LennartKlaver/SDVN1/Documentation/Shine1Hardware.jpg

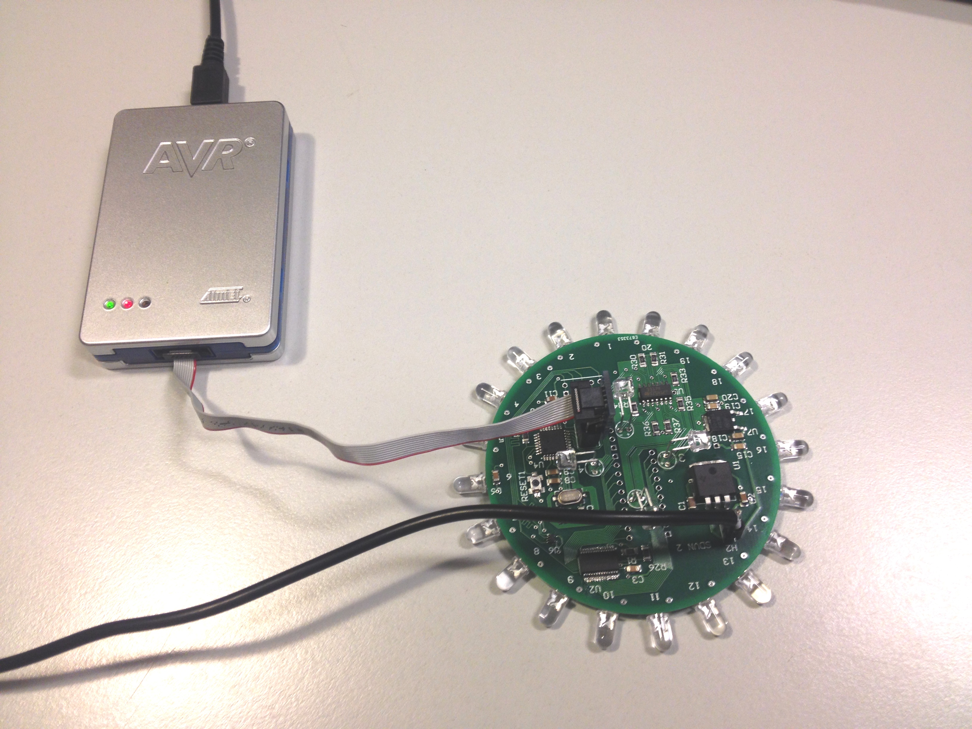
Documentation/Shine1Hardware.jpg
