LennartKlaver/SDVN1/Documentation/Shine1PDmount.jpg

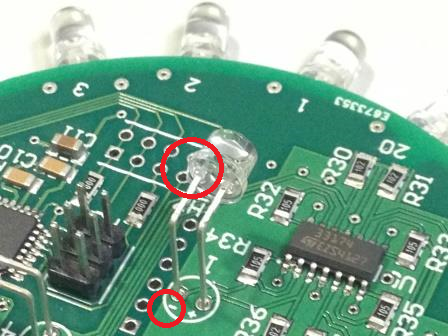
Documentation/Shine1PDmount.jpg
