LennartKlaver/SDVN1/README.md

# SDVN2
Shine: Developing Visual Networking

This repo contains the software and hardware for the Shine project in the Embedded Software group of the faculty EEMCS at Delft University of Technology.

The source files are part of [this paper](http://citeseerx.ist.psu.edu/viewdoc/download?doi=10.1.1.728.4979&rep=rep1&type=pdf) and [this Master thesis](http://resolver.tudelft.nl/uuid:439b72d1-0a8b-4132-8370-b539c8a13574)

[Embedded Software group website](http://www.es.ewi.tudelft.nl/)  

For questions please contact Lennart Klaver or Marco Zuniga.
