LennartKlaver/SDVN1/Documentation/PulsePositionModulation.png

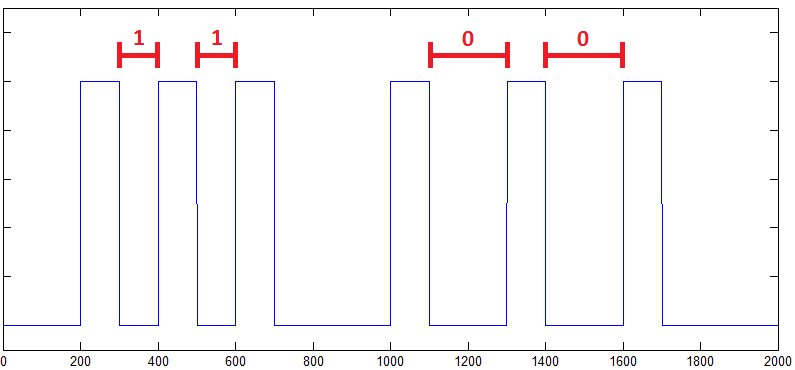
Documentation/PulsePositionModulation.png
