LennartKlaver/SDVN1/Documentation/sampling.png

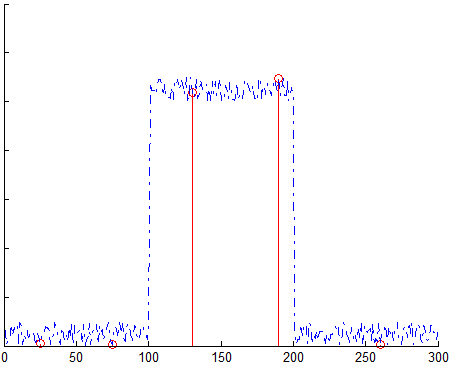
Documentation/sampling.png
