LennartKlaver/SDVN1/Documentation/signal.png

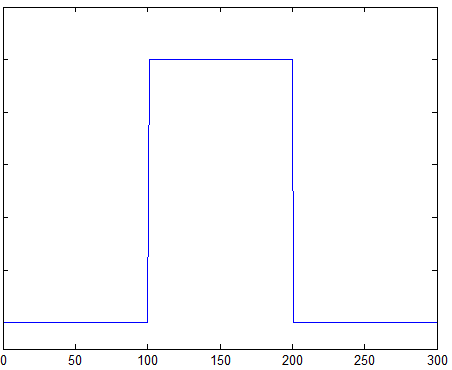
Documentation/signal.png
