LennartKlaver/SDVN1/Documentation/signalnoise.png

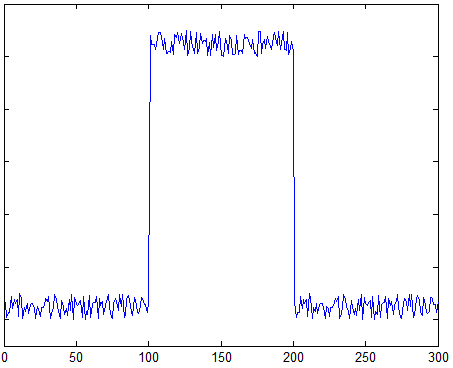
Documentation/signalnoise.png
