LennartKlaver/SDVN1/Hardware/SDVN2 schematic.pdf

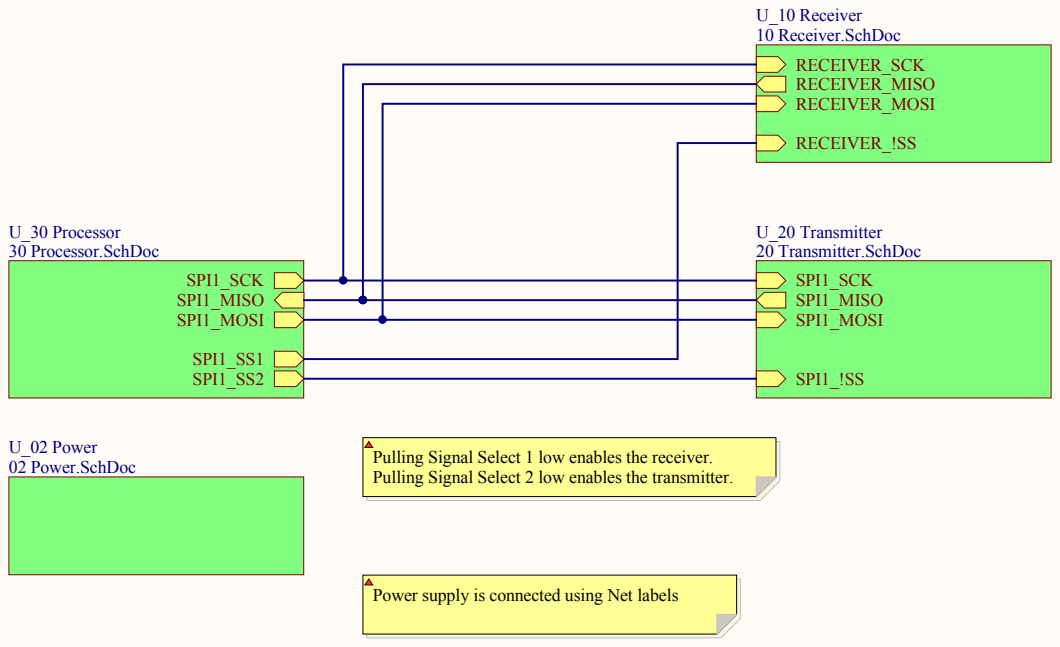
[picture p7: page 1]

Pulling Signal Select 1 low enables the receiver.
Pulling Signal Select 2 low enables the transmitter.

Power supply is connected using Net labels

Description: Top level overview

Drawn by: L.P. Klaver | Project: SDVN test1

Delft University of Technology | Sheet 1 of 12 | Rev.:14-3-2014

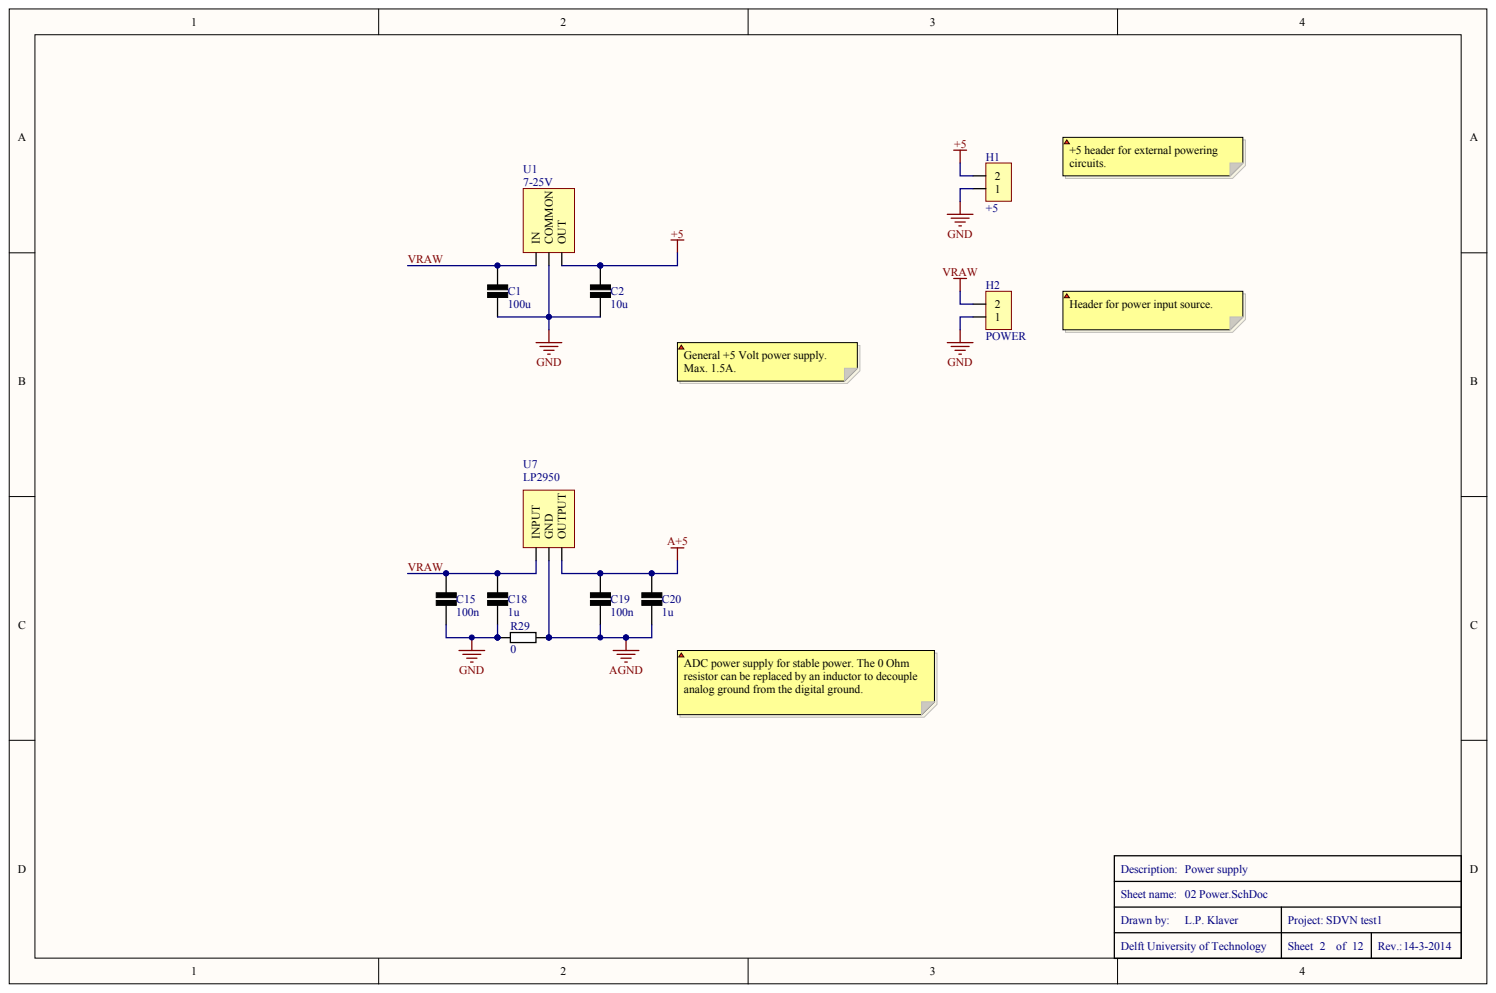
[picture p8: page 2]

ader for external powering

ader for power input sourc

General +5 Volt power supply.
Max. 1.5A.

ADC power supply for stable power. The 0 Ohm
sistor c
analog ground from the digital ground.

ed by an inductor to de

Drawn by: L.P. Klave r | Proje ct: SDVN te st1

Delft University of Te chnology | She et of 2 12 | Rev.:14-3-2014

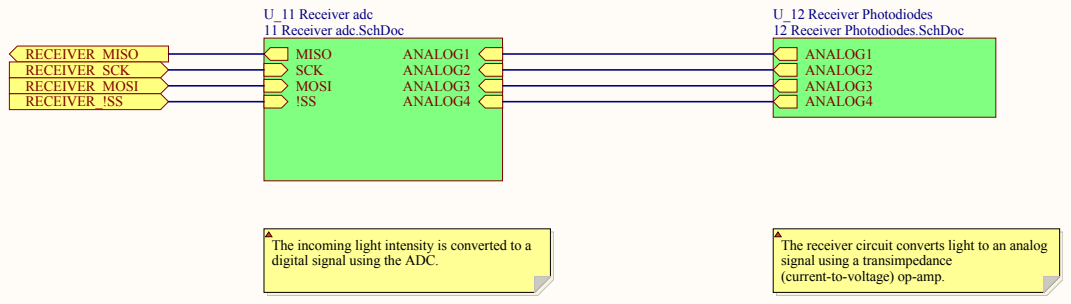
[picture p9: page 3]

The incoming light intensity is converted to a
digital signal using the ADC.

The receiver circuit converts light to an analog
signal using a transimpedance
(current-to-voltage) op-amp.

Drawn by: L.P. Klaver | Project: SDVN test1

Sheet of 3 12

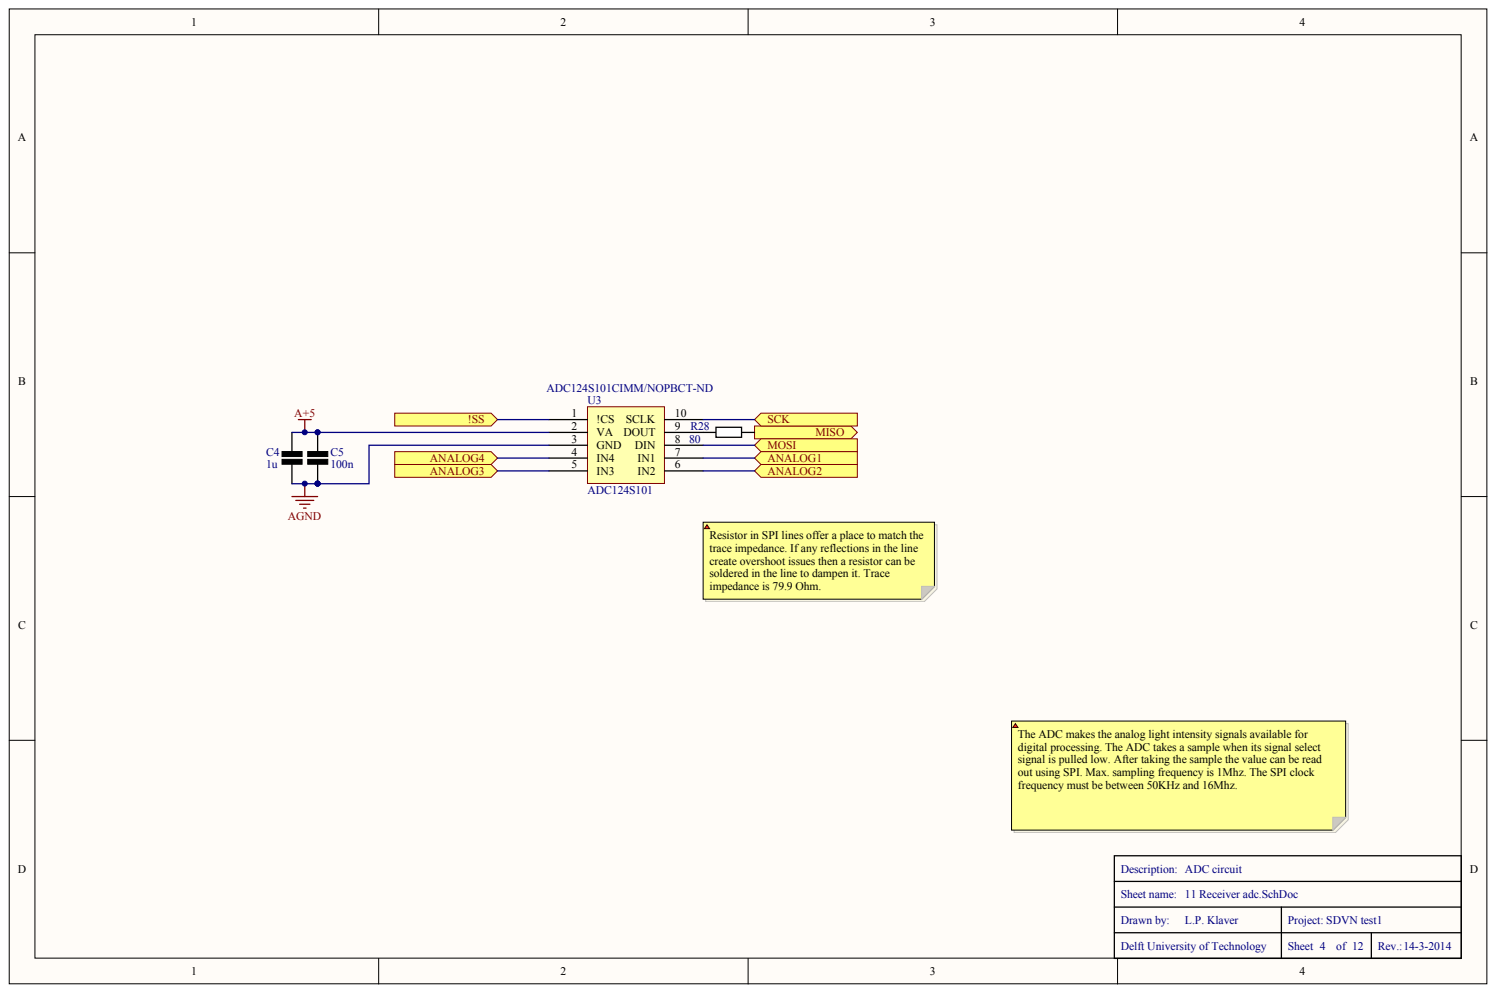
[picture p10: page 4]

C5 ANALOG4 100n

sistor in SPI line
e impedanc
tra
ate overshoot is
cre
soldered in the line to dampen it. Tra
impedanc

The ADC make
digital proc
signal is pulled low. After taking the s
out using SPI. Max. s
frequency must be betwe

s the analog light intensity signals available for
sing. The ADC take

ample when its signal s
ample the value c

ampling frequency is 1Mhz. The SPI clock
en 50KHz and 16Mhz

Drawn by: L.P. Klave r | Proje ct: SDVN te st1

Delft University of Te chnology | She et of 4 12 | Rev.:14-3-2014

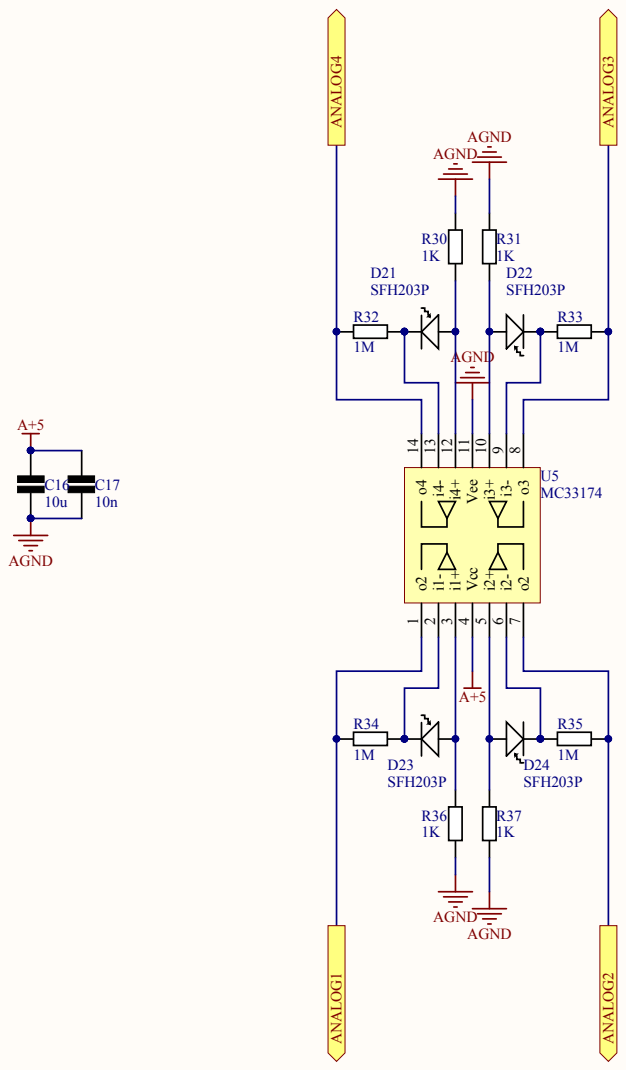
[picture p11: page 5]

Description: Photodiode and op-amp circuit

Drawn by: L.P. Klaver | Project: SDVN test1

Sheet of 5 12

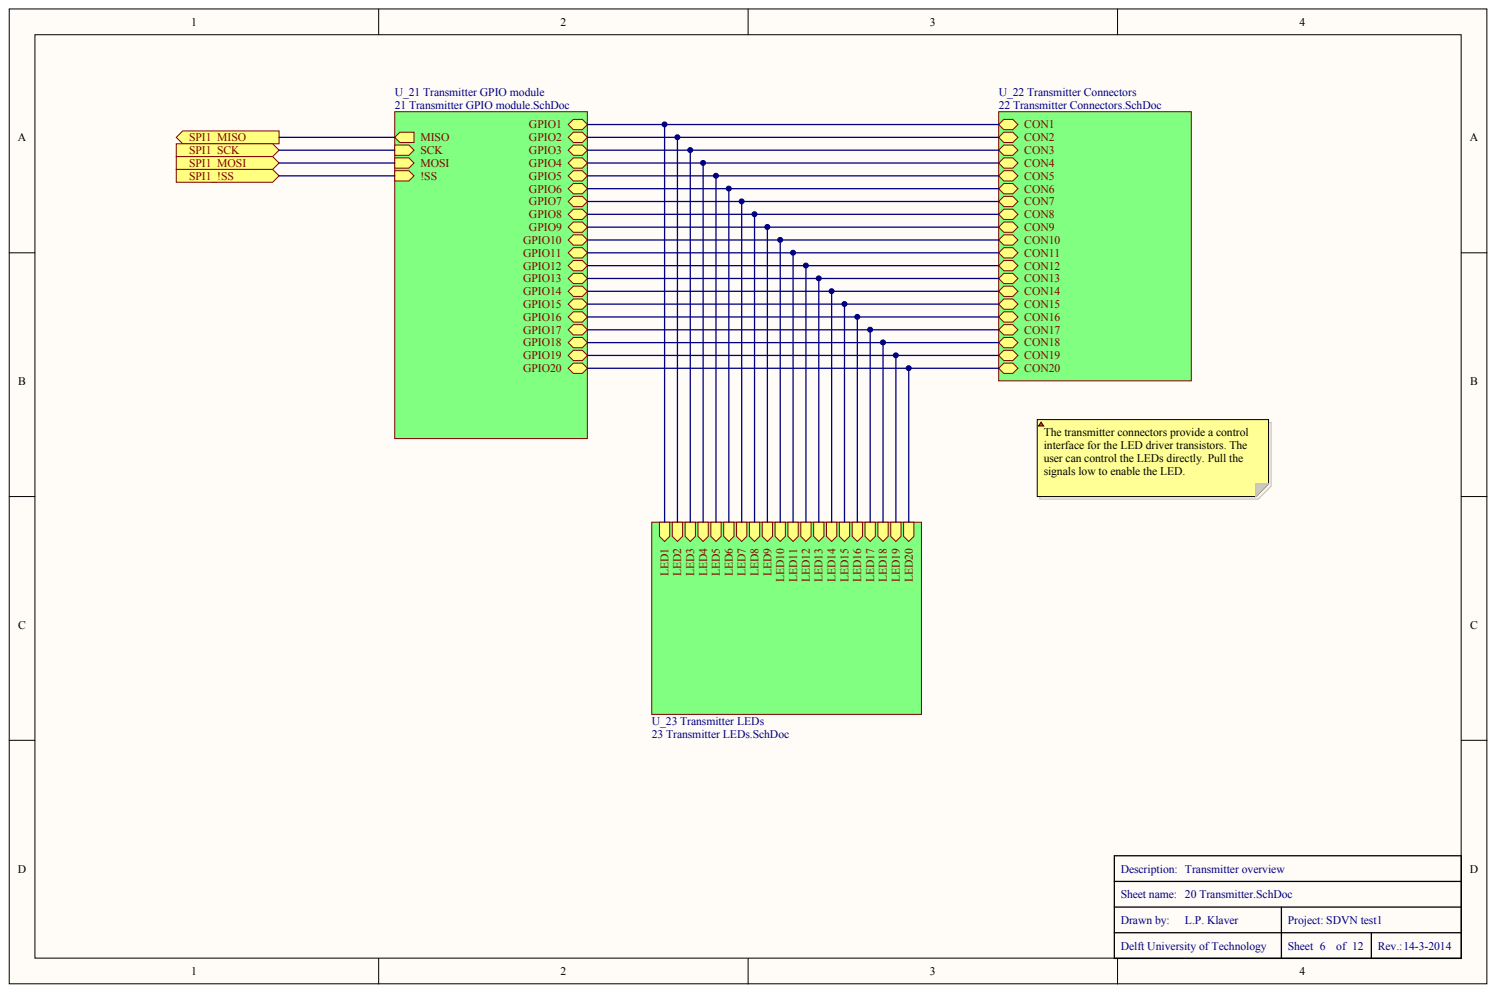
[picture p12: page 6]

U_21 Transmitter GPIO module
21 Transmitter GPIO module.SchDoc

The transmitter connectors provide a control
interface for the LED driver transistors. The
user can control the LEDs directly. Pull the
signals low to enable the LED.

Drawn by: L.P. Klaver | Project: SDVN test1

Sheet of 6 12

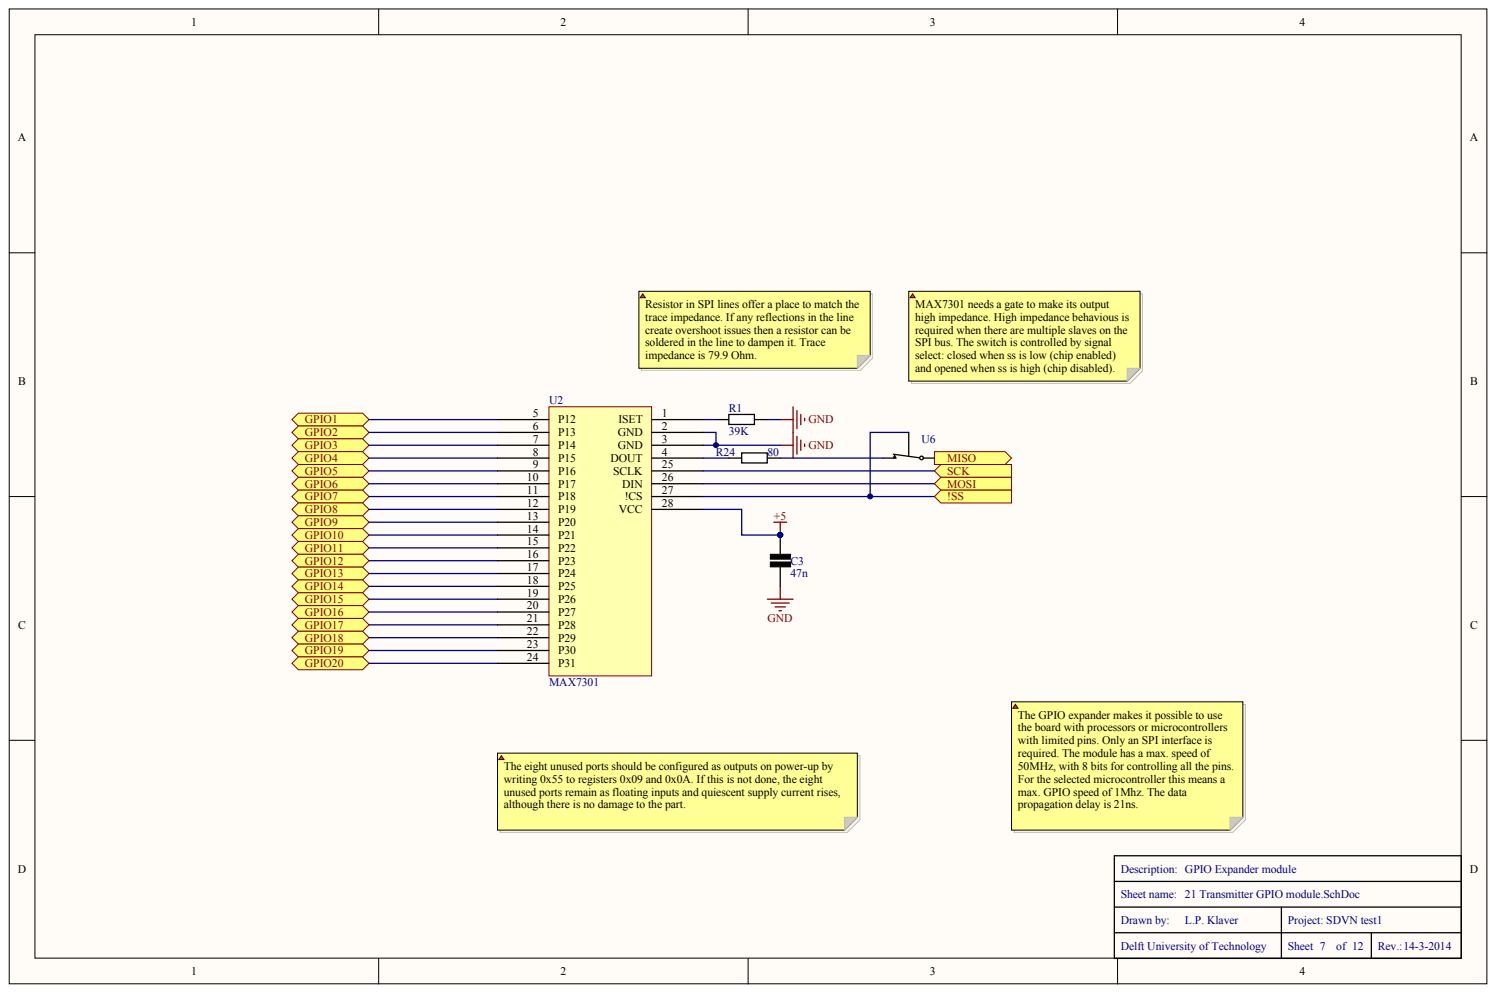
[picture p13: page 7]
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

MAX7301 ne
high impedanc
required when there are multiple slave
SPI bus. The switch is controlled by signal select: closed when ss is low (chip enabled) and opened when ss is high (chip disabled).

eds a gate to make its output
e. High impedanc

The GPIO expander make
the board with proc
with limited pins. Only an SPI interfa
required. The module ha
50MHz, with 8 bits for controlling all the pins
For the s
max. GPIO spe
propagation delay is 21ns

The eight unus
writing 0x55 to registers 0x09 and 0x0A. If this is not done, the eight
ed ports remain a
unus
although there is no damage to the part.

ed ports should be configured a

s outputs on power-up by

ele
ed of 1Mhz. The data

cted microcontroller this me

s floating inputs and quie

ent supply current ris

cription: GPIO Expander module

21 Transmitter GPIO module.SchDoc

Drawn by: L.P. Klave r | Proje ct: SDVN te st1

Delft University of Te chnology | She et of 7 12 | Rev.:14-3-2014

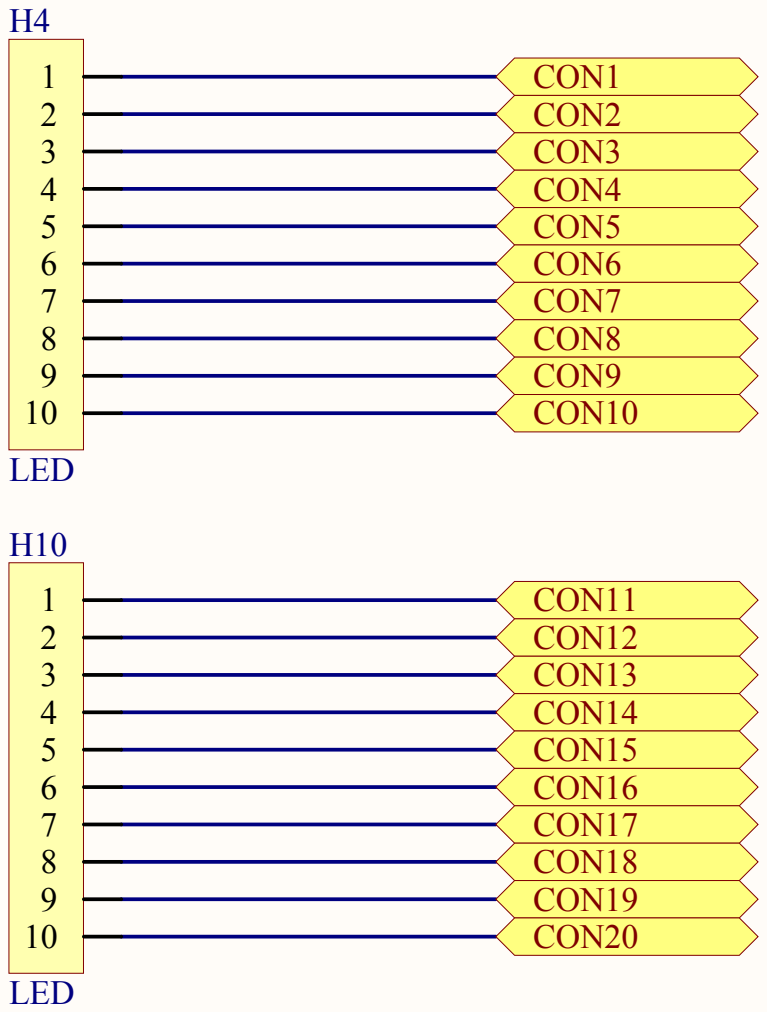
[picture p14: page 8]

Drawn by: L.P. Klave r | Proje ct: SDVN te st1

Delft University of Te chnology | She et of 8 12 | Rev.:14-3-2014

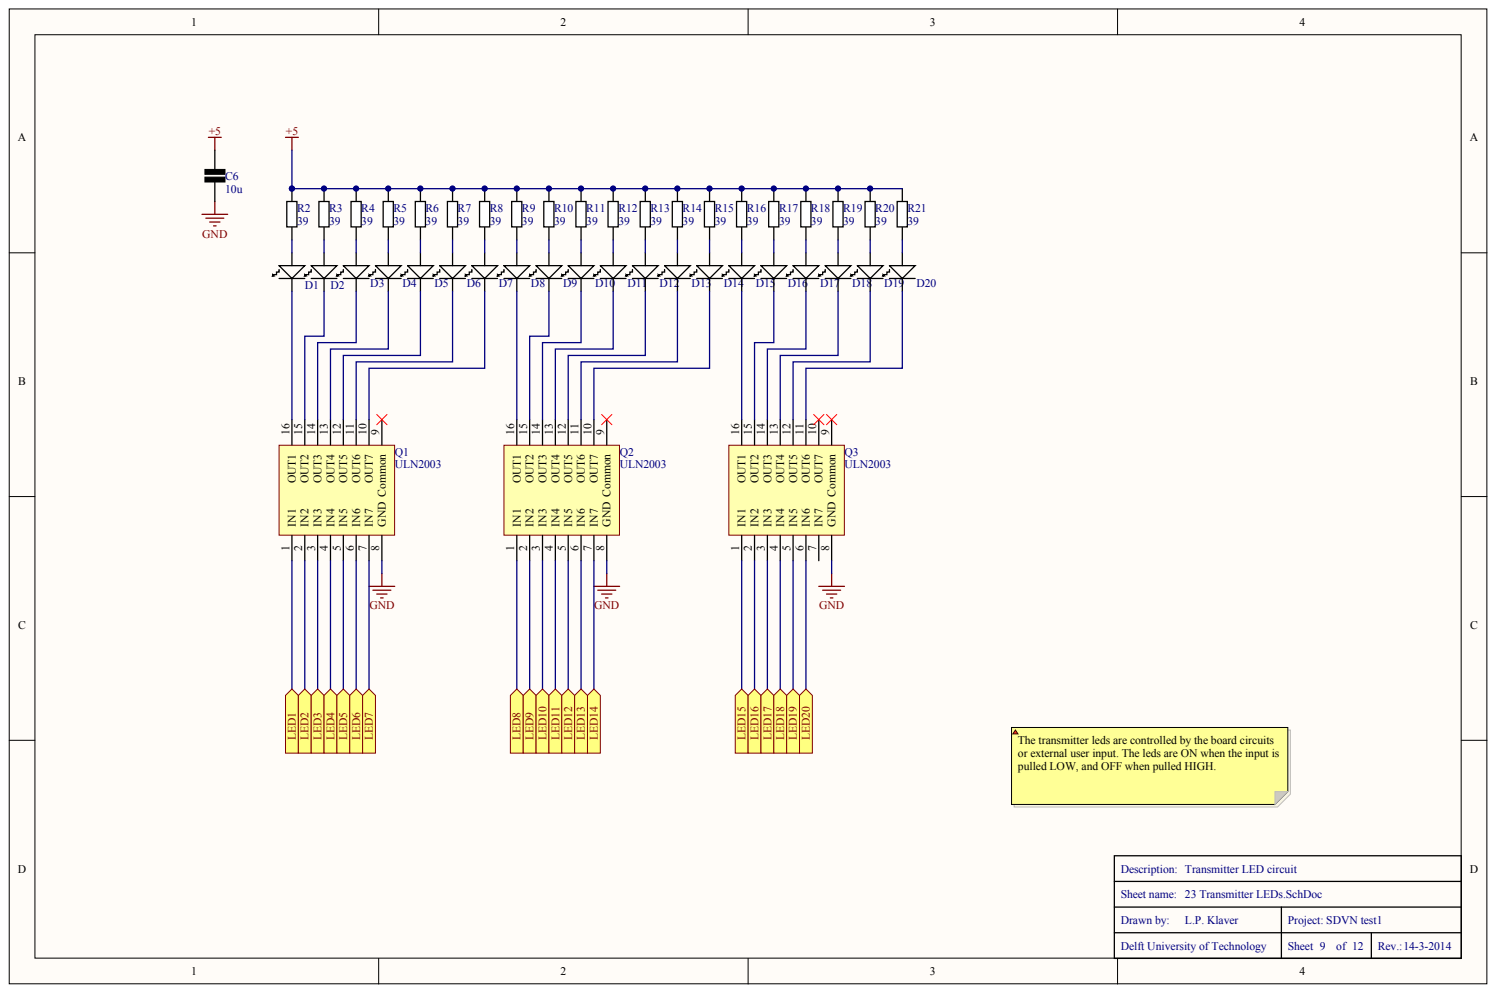
[picture p15: page 9]

The transmitter leds are controlled by the board circuits
or external user input. The leds are ON when the input is
pulled LOW, and OFF when pulled HIGH.

Description: Transmitter LED circuit

Drawn by: L.P. Klaver | Project: SDVN test1

Sheet of 9 12

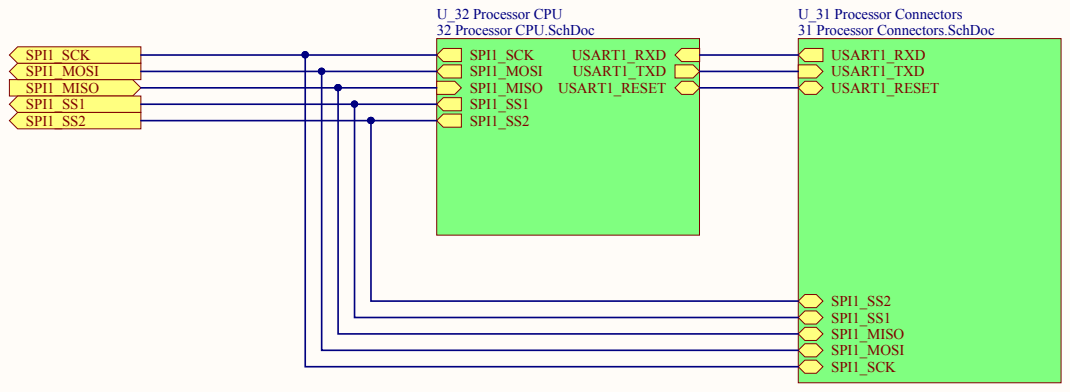
[picture p16: page 10]

Drawn by: L.P. Klaver | Project: SDVN test1

Sheet of 10 12

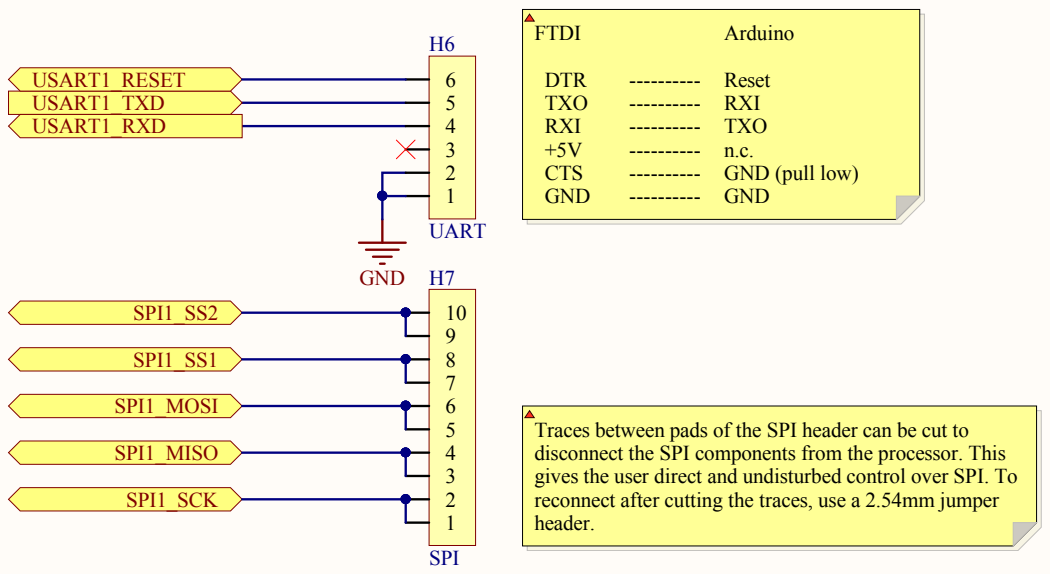
[picture p17: page 11]

Traces between pads of the SPI header can be cut to
disconnect the SPI components from the processor. This
gives the user direct and undisturbed control over SPI. To
reconnect after cutting the traces, use a 2.54mm jumper
header.

Description: Processor interface connectors

Drawn by: L.P. Klaver | Project: SDVN test1

Sheet of 11 12

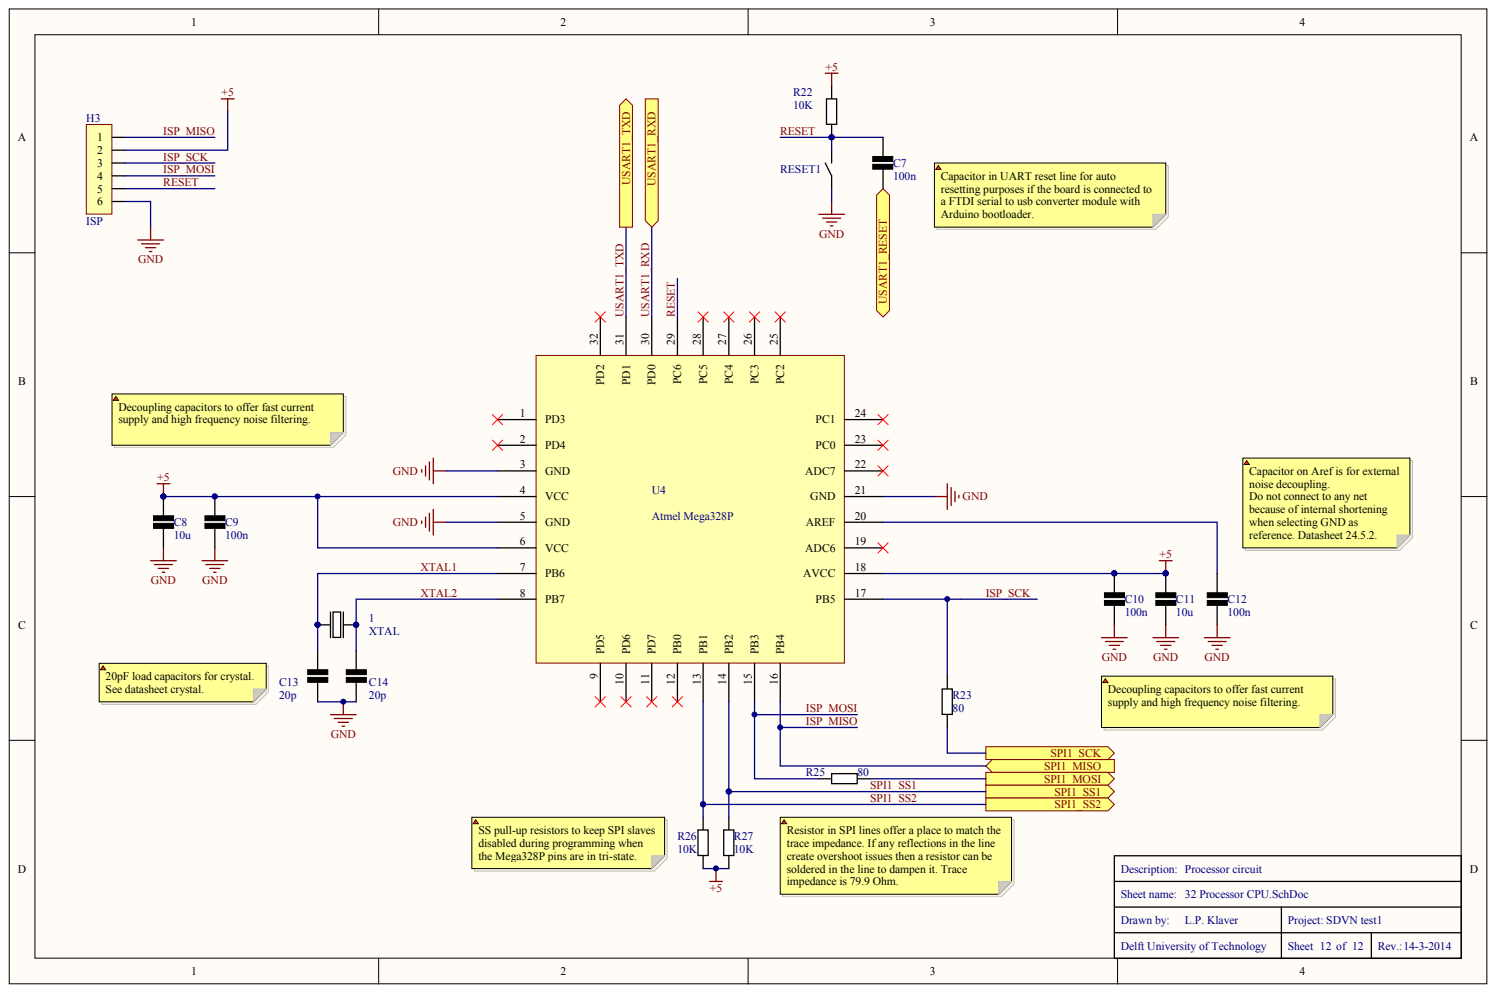
[picture p18: page 12]

et line for auto
s if the board is conne
erial to usb converter module with

coupling c
supply and high frequency nois

citors to offer fa
apa

XTAL2 | 8

ISP_MOSI
ISP_MISO

SS pull-up re
dis
the Mega328P pins are in tri-state

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

abled during programming when

Drawn by: L.P. Klave r | Proje ct: SDVN te st1

Delft University of Te chnology | She et of 12 12 | Rev.:14-3-2014

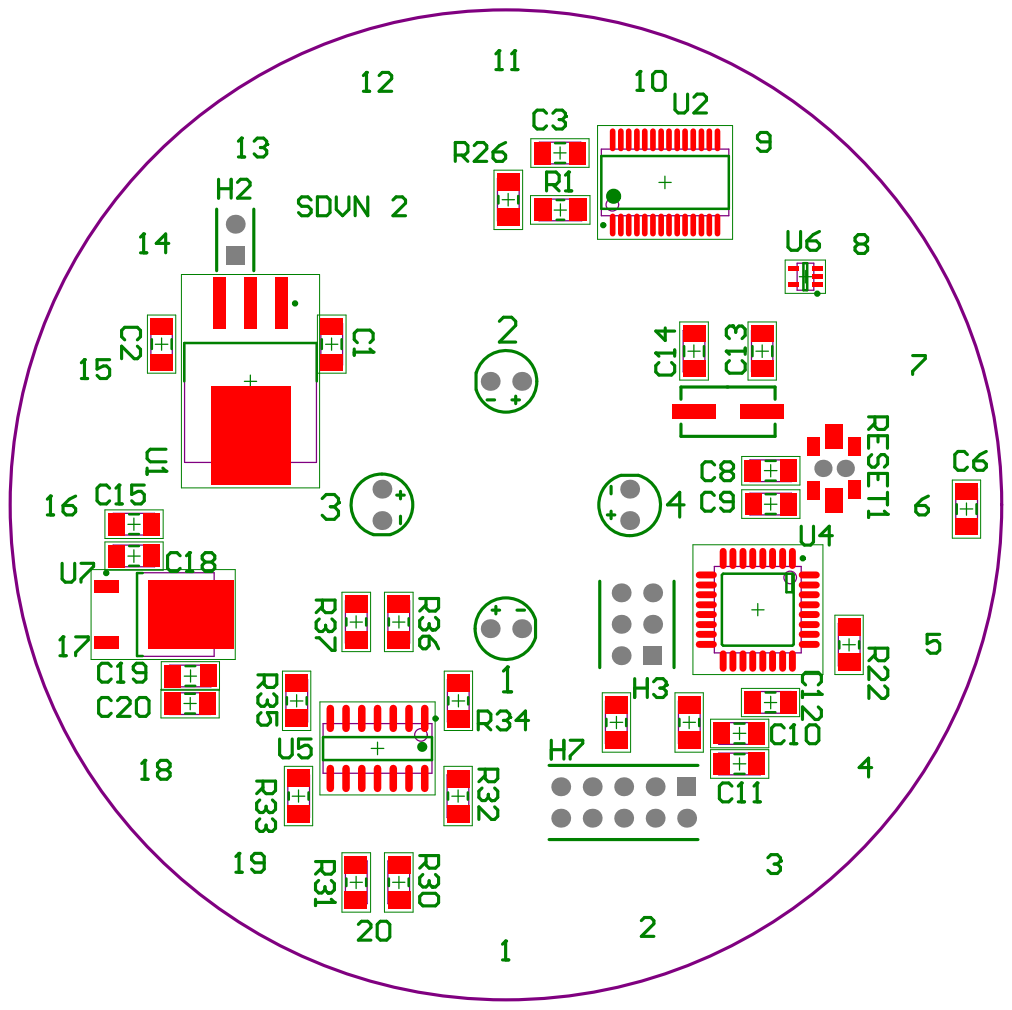
[picture p19: page 13]

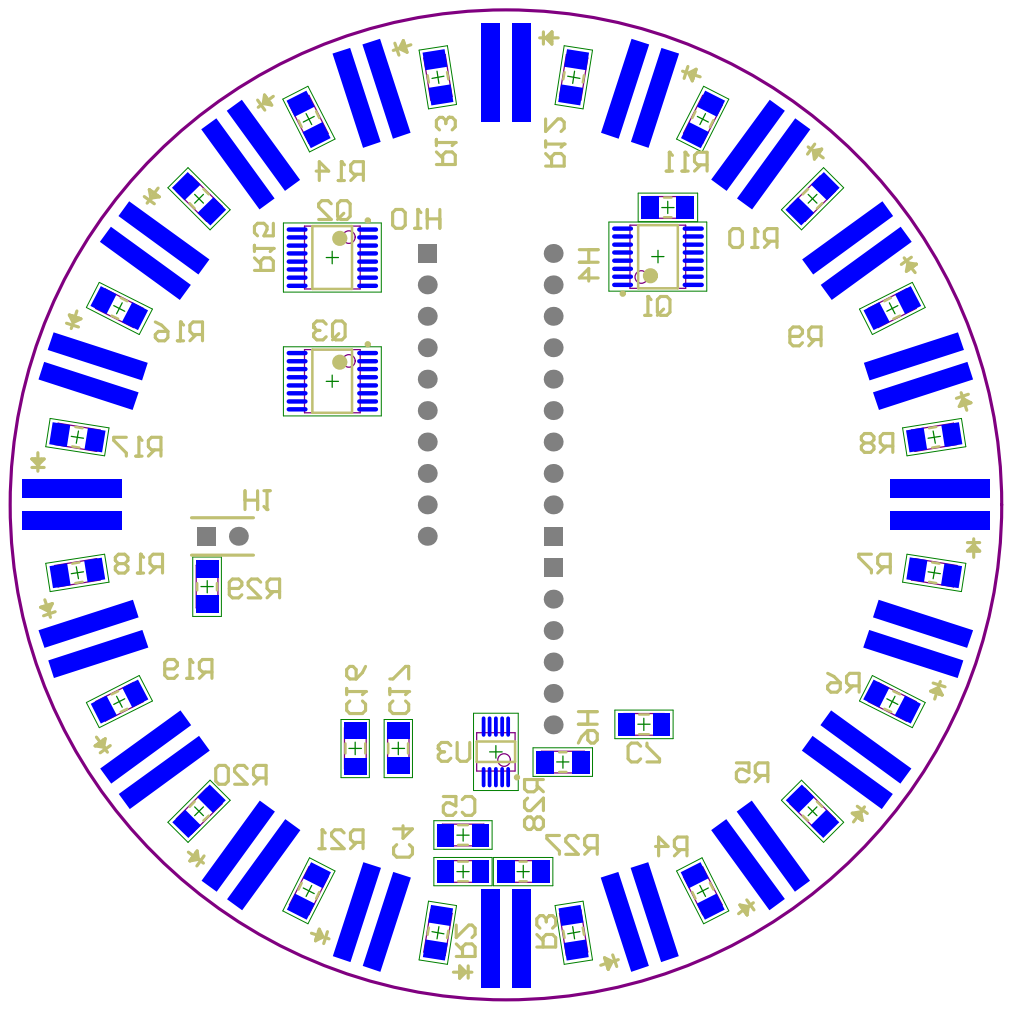
[picture p20: page 14]
