LennartKlaver/SDVN1/Firmware/main.h

/*
 * main.h
 *
 * Created: 25-11-2014 10:48:15
 *  Author: Lennart
 */ 
#ifndef MAIN_H_
#define MAIN_H_

/************************************************************************/
/* LIBRARIES                                                            */
/************************************************************************/
#include <avr/io.h>
#include <avr/interrupt.h>
#include "timer/timer.h"
#include "spi/spi.h"
#include "uart/uart.h"
#include "transmitter/transmitter.h"
#include "receiver/receiver.h"
#include "uart/uartcontroller.h"

/************************************************************************/
/* DEFINITIONS                                                          */
/************************************************************************/

/************************************************************************/
/* PROTOTYPES                                                           */
/************************************************************************/

/************************************************************************/
/* INLINE FUNCTIONS                                                     */
/************************************************************************/
#endif /* MAIN_H_ */
