LennartKlaver/SDVN1/Network Stack/Stack/datatypes/Channel.h

#pragma once

typedef enum {
	CHANNEL1 = 0,
	CHANNEL2 = 1,
	CHANNEL3 = 2,
	CHANNEL4 = 3,
	NUM_CHANNELS = 4
} Channel;
